liqunmaster/Dust_HeavyRobot/README

# Dust_HeavyRobot

同一仓库中的两个独立 Zephyr 固件工程：

- `firmware/Dust_HeavyRobot_H`：yaw、pitch、shoot 与 H 板间桥接。
- `firmware/Dust_HeavyRobot_L`：chassis、liftup、booster 与 L 板间桥接。

两端板间通信实现各自命名为 `App/mcu_common.cpp/.hpp`；公共输入映射位于 `firmware/common/input_manager.*`，仿真子模块位于 `firmware/test`。公共构建装配为 `cmake/mcu_common.cmake`。

共享 `math/`、`Topic/msg/`、协议、驱动和公共模块。两个工程各自持有入口、配置、应用清单与编译数据库。

在 PowerShell 中通过唯一构建烧录入口操作：

```powershell
& '.\Script\build&flash.cmd' H Build
& '.\Script\build&flash.cmd' L Build
& '.\Script\build&flash.cmd' H Flash
& '.\Script\build&flash.cmd' L Flash Vllink
```

完整参数为 `[H|L] [Build|Flash|Server] [Auto|Vllink|DAP] [10..4000 kHz]`，缺省为 `H Flash Auto 10`。`Auto` 默认 H、L 均使用 Vllink，速度均为 10 kHz；VS Code 的 `Debug H`、`Debug L` 也均使用 Vllink。当前工具链配置为本机 `D:/MCU/` 安装位置。

产物位于 `build/build_h/zephyr/`、`build/build_l/zephyr/`，名称仍为 `Dust_HeavyRobot.elf`、`Dust_HeavyRobot.bin`。VS Code 构建烧录任务也调用同一 cmd。

架构、消息使用和迁移验证详见 [第一阶段实施记录](Doc/双板架构第一阶段实施记录.md)。线程调度与离线策略的后续方案见 [实施方案](Doc/架构改造实施方案_待审核.md)。
