liqunmaster/Dust_HeavyRobot/Health_Monitor/README

# Health Monitor

本目录监测 CPU 负载和已绑定 CAN 电机的有效反馈 并通过板载 WS2812B 显示 CPU 负载水平。

## 文件

- `cpu_usage.hpp/.cpp`：声明并实现 CPU 采样、灯带显示与健康巡检的定时信号量循环，状态由 `CpuUsage` 和 `HealthMonitor` 对象持有。
- `motor_health.hpp/.cpp`：电机离线检测与恢复周期入口。
- `CMakeLists.txt`：将本目录加入应用的头文件搜索路径。

## CPU 负载显示

H/L 各自的 `firmware/Dust_HeavyRobot_H/main.cpp`、`firmware/Dust_HeavyRobot_L/main.cpp` 调用 `health_monitor_run()`；其定时器每 10 ms 释放信号量，主线程唤醒后执行 `health_monitor_poll()`。其中 `cpu_usage_supervisor()` 每 500 ms 更新一次 LED。

负载来自 Zephyr 的 `cpu_load_get(true)` 使用 idle hook 后端按采样区间计算 CPU 忙碌比例。采样失败时 LED 熄灭。

WS2812B 使用四分之一权重的指数平滑值显示负载，采用三档固定颜色：低于 50% 显示纯绿 RGB=(0,126,0)，50%～75%（包含两个端点）显示纯黄 RGB=(126,126,0)，高于 75% 显示纯红 RGB=(126,0,0)。`Sample()` 返回未经平滑的区间负载，`cpu_usage_latest_percent()` 读取缓存。红色和绿色通道的最大值为 126，蓝色通道始终为 0。LED 的实际发送由 `Device/ws2812b` 和 `Bsp/bsp_ws2812b` 完成。

本功能依赖 `prj.conf` 中的 `CONFIG_CPU_LOAD=y` 和 `CONFIG_CPU_LOAD_BACKEND_IDLE_HOOK=y` 不依赖线程运行统计。LED 显示的是采样区间内的 CPU 忙碌比例 并非单次函数调用的耗时。

## 电机离线恢复

`main()` 调用 `health_monitor_init()` 初始化监测，应用任务绑定电机后，通过 `health_monitor_run()` 每 10 ms 执行 `motor_health_poll()`。该函数扫描 `canfd_port` 中的已绑定电机；C610/C620 根据自主反馈超时记录离线状态 底盘任务根据反馈新鲜度独立决定是否输出电流。DM 拨弹电机由 `App/app_booster.cpp` 的状态机恢复。CubeMars 首次发送使能帧后等待反馈 收到使能帧之后的有效反馈才开始发送控制帧。首次使能或控制期间超过 100 ms 未收到有效反馈 就每 50 ms 重复发送使能帧；恢复反馈后继续正常控制。

底盘的 0x200 电流帧只由底盘任务构建和发布；没有新运动指令时每 20 ms 发送一次零电流帧。健康监测不另发恢复电流帧。超时与重发周期直接在 `motor_health.cpp` 的判断和恢复逻辑中调整。CAN bus-off 和发送卡住由 `canfd_port` 的总线状态恢复逻辑处理 电机离线监控只处理单电机的反馈缺失。
