liqunmaster/Dust_HeavyRobot/Board/hpm5361/doc/HPM5361/HPM5361主控板.kicad_pcb

## KiCad design Board/hpm5361/doc/HPM5361/HPM5361主控板.kicad_pcb (continued)

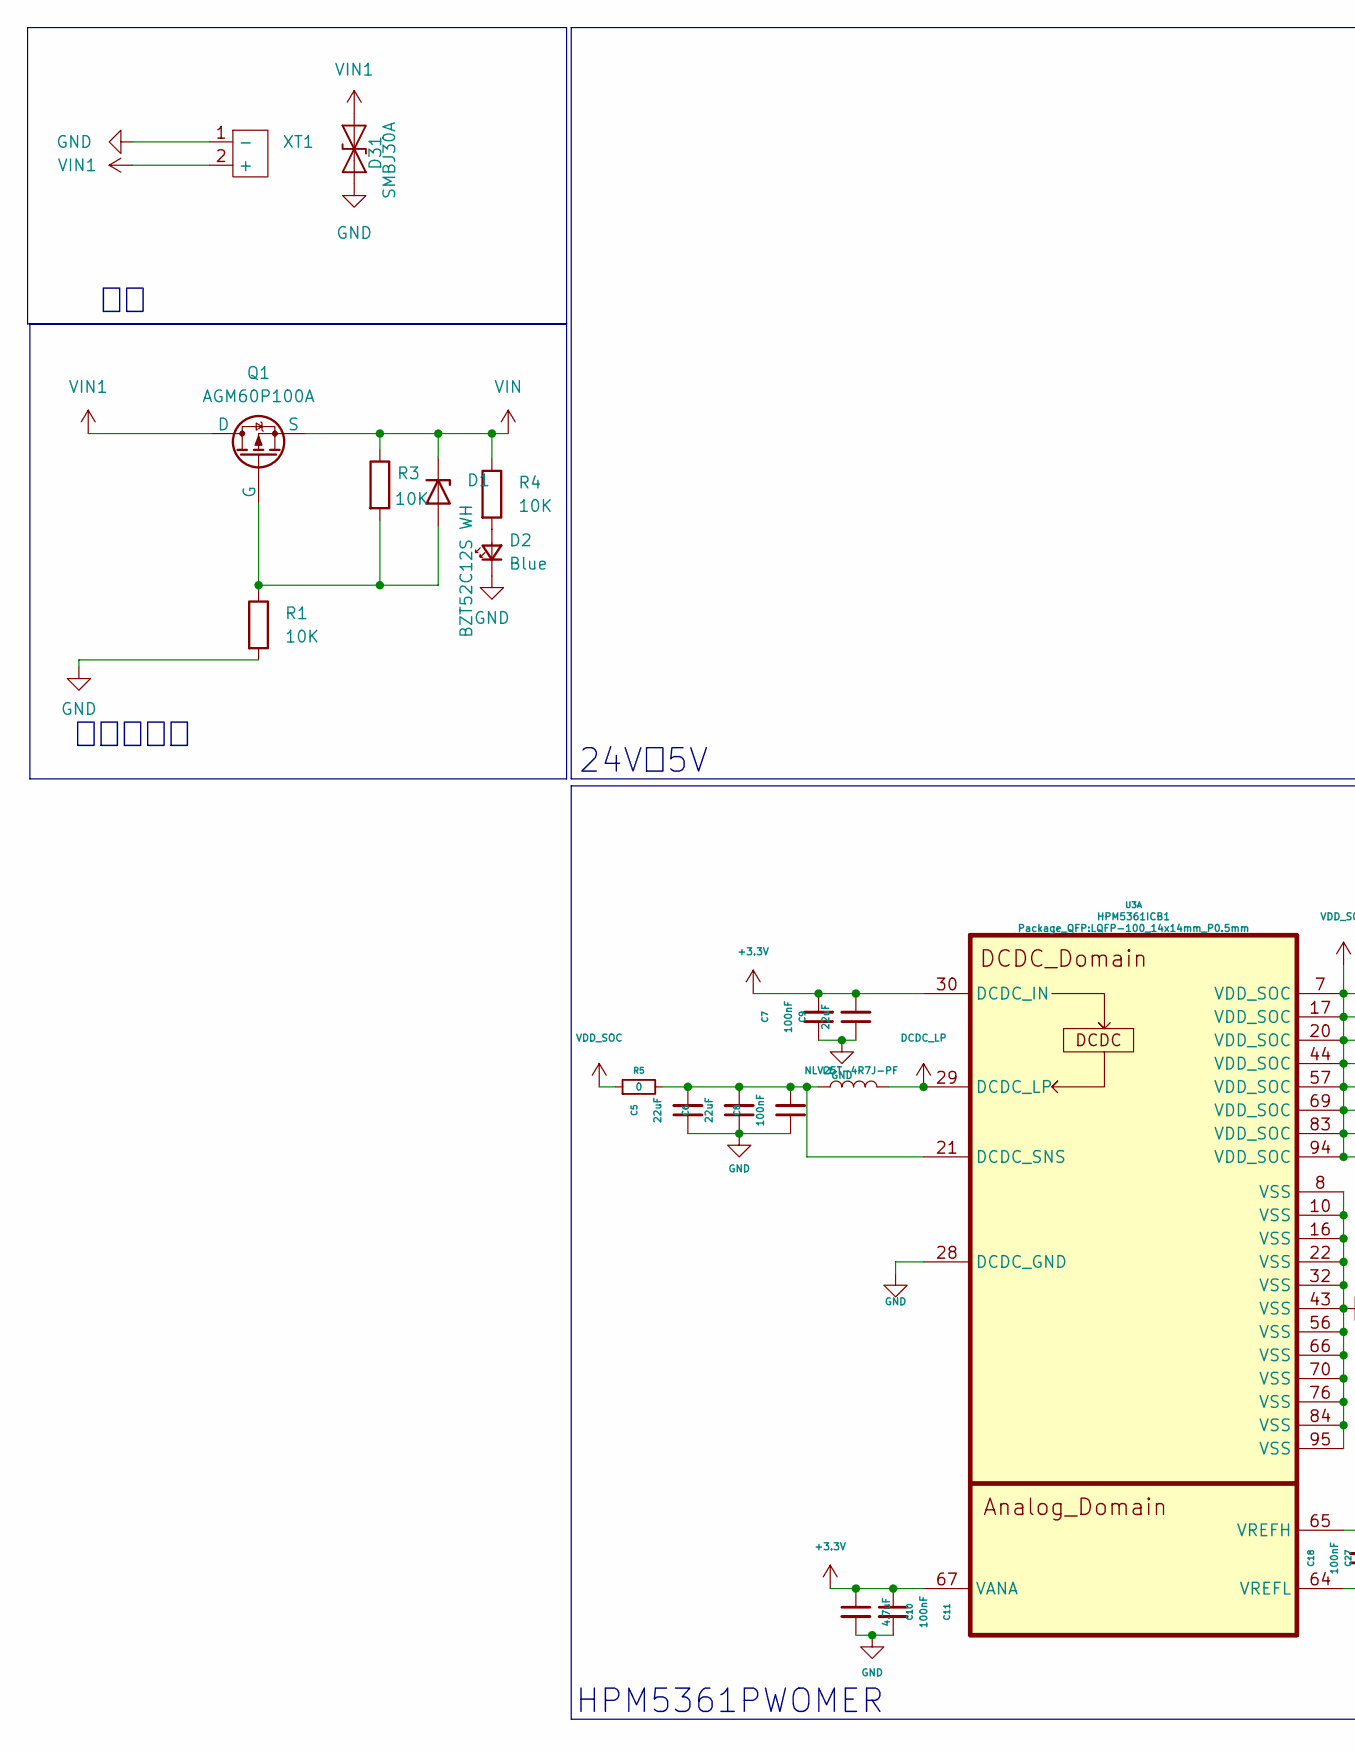
[picture p5: schematic power.kicad_sch, part in row 1, column 1]

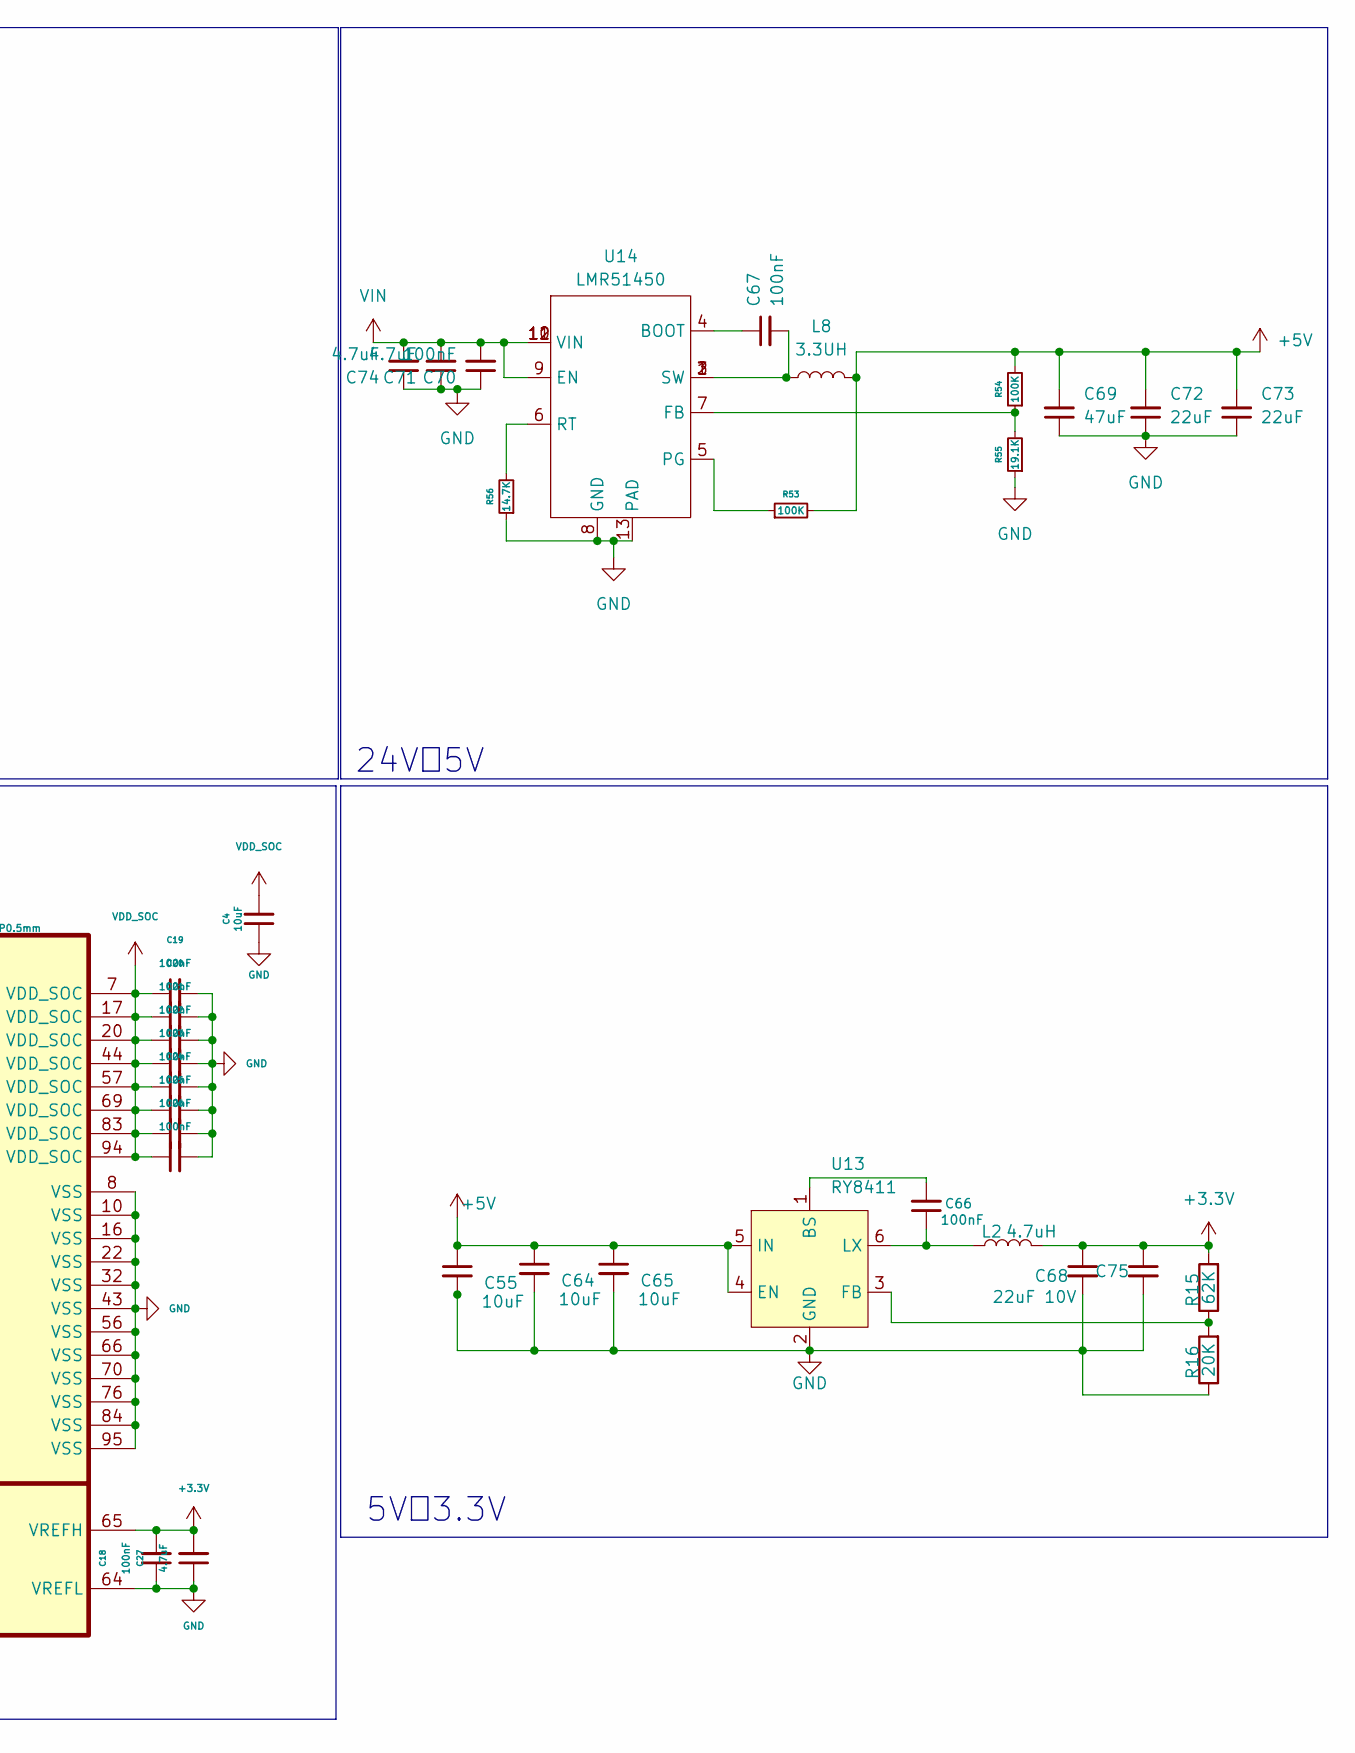
[picture p6: schematic power.kicad_sch, part in row 1, column 2]

Parts:
C4: 10uF; C_0402_1005Metric; Voltage 1kV; Tolerance 100%
C5, C6, C9: 22uF; C_0402_1005Metric; Voltage 1kV; Tolerance 100%
C7, C8, C11, C18, C19, C20, C21, C22, C23, C24, C25, C26, C70: 100nF; C_0402_1005Metric; Voltage 1kV; Tolerance 100%
C10, C27: 4.7uF; C_0402_1005Metric; Voltage 1kV; Tolerance 100%
C55, C64, C65: 10uF; C_0603_1608Metric
C66: 100nF; C_0603_1608Metric
C67: 100nF; C_0603_1608Metric; Voltage 1kV; Tolerance 100%
C68, C75: 22uF 10V; C_1206_3216Metric
C69: 47uF; C_1206_3216Metric; Voltage 1kV; Tolerance 100%
C71, C74: 4.7uF; C_0603_1608Metric; Voltage 1kV; Tolerance 100%
C72, C73: 22uF; C_1206_3216Metric; Voltage 1kV; Tolerance 100%
D1: BZT52C12S WH; D_SOD-323
D2: Blue; LED_0603_1608Metric
D31: SMBJ30A; D_SMB
L1: NLV25T-4R7J-PF; L_1008_2520Metric
L2: 4.7uH; L_APV_APH0420
L8: 3.3UH; L_APV_APH0630
Q1: AGM60P100A; PQFN-8-EP_6x5mm_P1.27mm_Generic
R1, R3: 10K; R_0402_1005Metric
R4: 10K; R_0603_1608Metric
R5: 0; R_0402_1005Metric
R15: 62K; R_0603_1608Metric
R16: 20K; R_0603_1608Metric
R53, R54: 100K; R_0402_1005Metric
R55: 19.1K; R_0402_1005Metric
R56: 14.7K; R_0402_1005Metric
U3: HPM5361ICB1; LQFP-100_14x14mm_P0.5mm
U13: RY8411; SOT-23-6
U14: LMR51450; WSON-12-1EP_3x3mm_P0.5mm_EP1.5x2.5mm
XT1: AMASS_XT30U-M_1x02_P5.0mm_Vertical

Connections:
+3.3V: C7.2, C9.2, C10.1, C11.1, C18.2, C27.2, C68.1, C75.1, L2.2, R15.2, U3.30 (DCDC_IN), U3.65 (VREFH), U3.67 (VANA); also elsewhere on the board
+5V: C55.1, C64.1, C65.1, C69.2, C72.2, C73.2, L8.2, R53.2, R54.2, U13.4 (EN), U13.5 (IN); also elsewhere on the board
DCDC_LP: L1.2, U3.29 (DCDC_LP)
GND: C4.1, C5.1, C6.1, C7.1, C8.1, C9.1, C10.2, C11.2, C18.1, C19.2, C20.2, C21.2, C22.2, C23.2, C24.2, C25.2, C26.2, C27.1, C55.2, C64.2, C65.2, C68.2, C69.1, C70.1, C71.1, C72.1, C73.1, C74.1, C75.2, D2.1 (K), D31.2 (A2), R1.2, R16.1, R55.1, R56.1, U3.8 (VSS), U3.10 (VSS), U3.16 (VSS), U3.22 (VSS), U3.28 (DCDC_GND), U3.32 (VSS), U3.43 (VSS), U3.56 (VSS), U3.64 (VREFL), U3.66 (VSS), U3.70 (VSS), U3.76 (VSS), U3.84 (VSS), U3.95 (VSS), U13.2 (GND), U14.8 (GND), U14.13 (PAD), XT1.1 (-); also elsewhere on the board
unnamed: C67.2, L8.1, U14.1 (SW), U14.2 (SW), U14.3 (SW)
unnamed: D1.2 (A), Q1.G, R1.1, R3.2
unnamed: D2.2 (A), R4.2
unnamed: C5.2, C6.2, C8.2, L1.1, R5.2, U3.21 (DCDC_SNS)
unnamed: C66.2, U13.1 (BS)
unnamed: R15.1, R16.2, U13.3 (FB)
unnamed: C66.1, L2.1, U13.6 (LX)
unnamed: C67.1, U14.4 (BOOT)
unnamed: R54.1, R55.2, U14.7 (FB)
unnamed: R53.1, U14.5 (PG)
unnamed: R56.2, U14.6 (RT)
VDD_SOC: C4.2, C19.1, C20.1, C21.1, C22.1, C23.1, C24.1, C25.1, C26.1, R5.1, U3.7 (VDD_SOC), U3.17 (VDD_SOC), U3.20 (VDD_SOC), U3.44 (VDD_SOC), U3.57 (VDD_SOC), U3.69 (VDD_SOC), U3.83 (VDD_SOC), U3.94 (VDD_SOC)
VIN: C70.2, C71.2, C74.2, D1.1 (K), Q1.S, R3.1, R4.1, U14.9 (EN), U14.10 (VIN), U14.11 (VIN), U14.12 (VIN)
VIN1: D31.1 (A1), Q1.D, XT1.2 (+)

Notes on the sheet:
24V转5V
输入防反接
5V转3.3V
HPM5361PWOMER

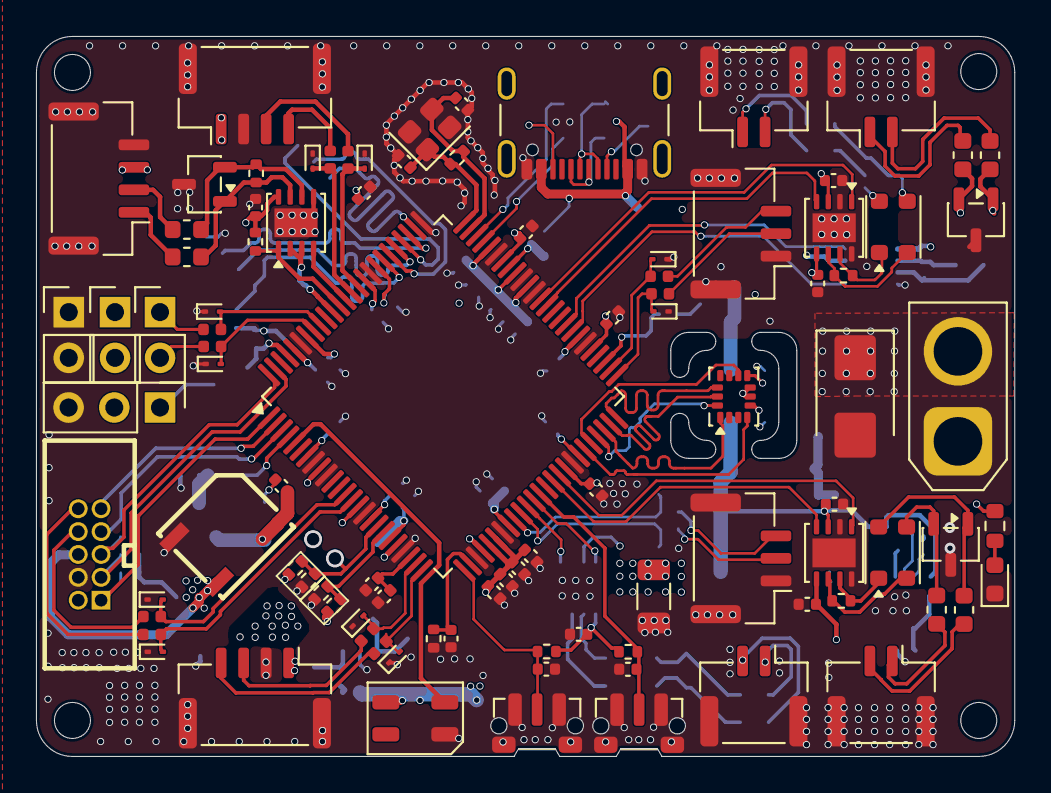
[picture p7: board HPM5361主控板.kicad_pcb from above]

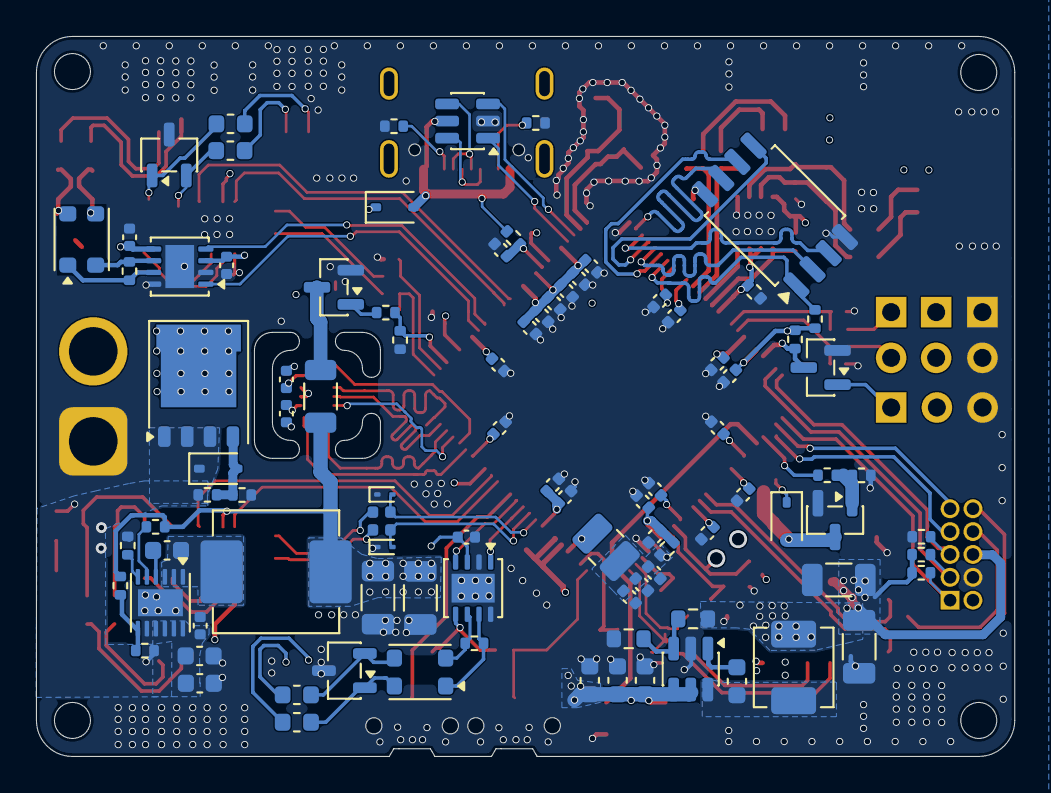
[picture p8: board HPM5361主控板.kicad_pcb from below]

Board: 4 copper layers, 54.3 x 40.0 mm, 189 parts (94 on the bottom side), 124 nets.
