liqunmaster/Dust_HeavyRobot/src/device/servo/servo.cpp

#include "servo.hpp"

namespace
{
constexpr uint16_t min_pulse_us = 1000;
constexpr uint16_t center_pulse_us = 1500;
constexpr uint16_t max_pulse_us = 2000;
constexpr uint16_t max_angle_degrees = 150;
constexpr uint32_t period_ns = PWM_MSEC(20);

const device *const pwm_device = DEVICE_DT_GET(DT_NODELABEL(pwm1));
}

int Servo::Init()
{
	if (_initialized) {
		return 0;
	}

	if (!device_is_ready(pwm_device)) {
		return -ENODEV;
	}

	if (_output != ServoOutput::p2 && _output != ServoOutput::p3) {
		return -EINVAL;
	}

	const int ret = pwm_set(pwm_device, static_cast<uint32_t>(_output), period_ns, PWM_USEC(center_pulse_us),
				PWM_POLARITY_NORMAL);

	if (ret == 0) {
		_initialized = true;
	}

	return ret;
}

int Servo::SetPulseUs(uint16_t pulse_us)
{
	if (!_initialized) {
		return -ENODEV;
	}

	if (pulse_us < min_pulse_us || pulse_us > max_pulse_us) {
		return -EINVAL;
	}

	return pwm_set(pwm_device, static_cast<uint32_t>(_output), period_ns, PWM_USEC(pulse_us), PWM_POLARITY_NORMAL);
}

int Servo::SetAngle(uint16_t degrees)
{
	if (degrees > max_angle_degrees) {
		return -EINVAL;
	}

	const uint16_t pulse_us = min_pulse_us + static_cast<uint16_t>((static_cast<uint32_t>(degrees) *
				  (max_pulse_us - min_pulse_us) + max_angle_degrees / 2) / max_angle_degrees);

	return SetPulseUs(pulse_us);
}
