liqunmaster/Dust_HeavyRobot/src/modules/manual_control/remote_port.hpp

#pragma once

#include <errno.h>
#include <zephyr/device.h>
#include <zephyr/devicetree.h>
#include <zephyr/drivers/uart.h>
#include "dvc_uart.hpp"
#include "input.hpp"
#include "remote_types.hpp"
#include "rx_chunk.hpp"

extern volatile uint32_t remote_port_loop_count;
extern volatile uint32_t remote_port_total_cycles;
extern volatile uint32_t remote_port_max_cycles;

class RemotePort
{
public:
	void init();

	uint32_t FeedbackCount();

private:
	struct RemoteTransport {
		const struct device *uart;
		RemoteUartSource source;
		::Uart *port;
	};

	static void RxNotify(void *arg1);

	static void PartialFrameTimeout(struct k_timer *arg1);

	static void PublishSample(const InputSample &sample, void *arg2);

	int InitUart(RemoteTransport &transport);

	void ReceiveUart(RemoteTransport &transport);

	static void task_trampoline(void *arg1, void *arg2, void *arg3);

	void Run();

	struct k_thread _remote_thread {};
	struct k_timer _partial_frame_timer {};
	atomic_t _feedback_count{};
	bool _started = false;
	RemoteTransport _transports[2] = {
		{DEVICE_DT_GET(DT_ALIAS(vt03_uart)), RemoteUartSource::uart1, nullptr},
		{DEVICE_DT_GET(DT_ALIAS(dt7_uart)), RemoteUartSource::uart4, nullptr},
	};
};

void remote_port_init();

uint32_t remote_port_feedback_count();
