liqunmaster/Dust_HeavyRobot/Device/icm42688p_hxy_reg.h

#pragma once

#include <stdint.h>

#define ICM42688PHXY_REG_WHO_AM_I 0x01
#define ICM42688PHXY_REG_COM_CFG 0x05
#define ICM42688PHXY_REG_INT_CFG1 0x06
#define ICM42688PHXY_REG_DATA_STAT 0x0B
#define ICM42688PHXY_REG_ACC_XH 0x0C
#define ICM42688PHXY_REG_TEMP_H 0x22
#define ICM42688PHXY_REG_ACC_CONF 0x40
#define ICM42688PHXY_REG_ACC_RANGE 0x41
#define ICM42688PHXY_REG_GYR_CONF 0x42
#define ICM42688PHXY_REG_GYR_RANGE 0x43
#define ICM42688PHXY_REG_SOFT_RST 0x4A
#define ICM42688PHXY_REG_PWR_CTRL 0x7D

#define ICM42688PHXY_WHO_AM_I_VALUE 0x6A
#define ICM42688PHXY_SPI_READ_BIT 0x80
#define ICM42688PHXY_COM_CFG_BDU_AUTO_INC 0x50
#define ICM42688PHXY_SOFT_RST_VALUE 0xA5
#define ICM42688PHXY_PWR_OFF 0x00
#define ICM42688PHXY_PWR_ALL_ON 0x0F
#define ICM42688PHXY_ACC_CONF_1600HZ 0x8C
#define ICM42688PHXY_GYR_CONF_1600HZ 0x8C
#define ICM42688PHXY_GYR_CONF_1600HZ_NOISE_OPT 0xCC
#define ICM42688PHXY_ACC_RANGE_16G 0x03
#define ICM42688PHXY_GYR_RANGE_2000DPS 0x00

#define ICM42688PHXY_DATA_STAT_GYR_CONF_ERR (1 << 5)
#define ICM42688PHXY_DATA_STAT_ACC_CONF_ERR (1 << 4)
#define ICM42688PHXY_DATA_STAT_GYR_READY (1 << 1)
#define ICM42688PHXY_DATA_STAT_ACC_READY (1 << 0)

#define ICM42688PHXY_SENSOR_FRAME_SIZE 12
#define ICM42688PHXY_TEMP_FRAME_SIZE 2
